forthy42/b16-small/alu.pdf

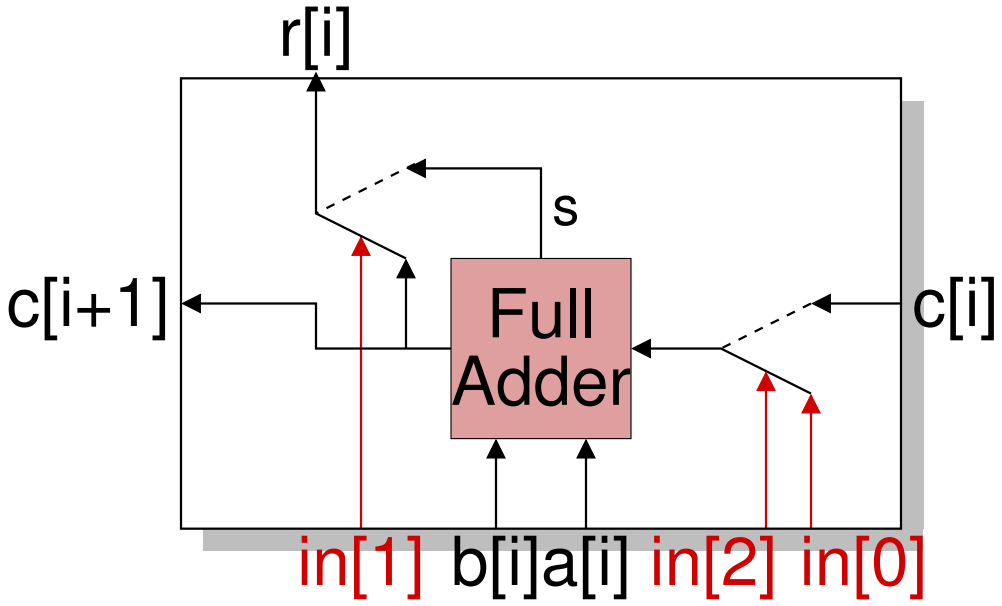
[picture p2: figure]
Adder; Full
