forthy42/b16-small/b16-small.pdf

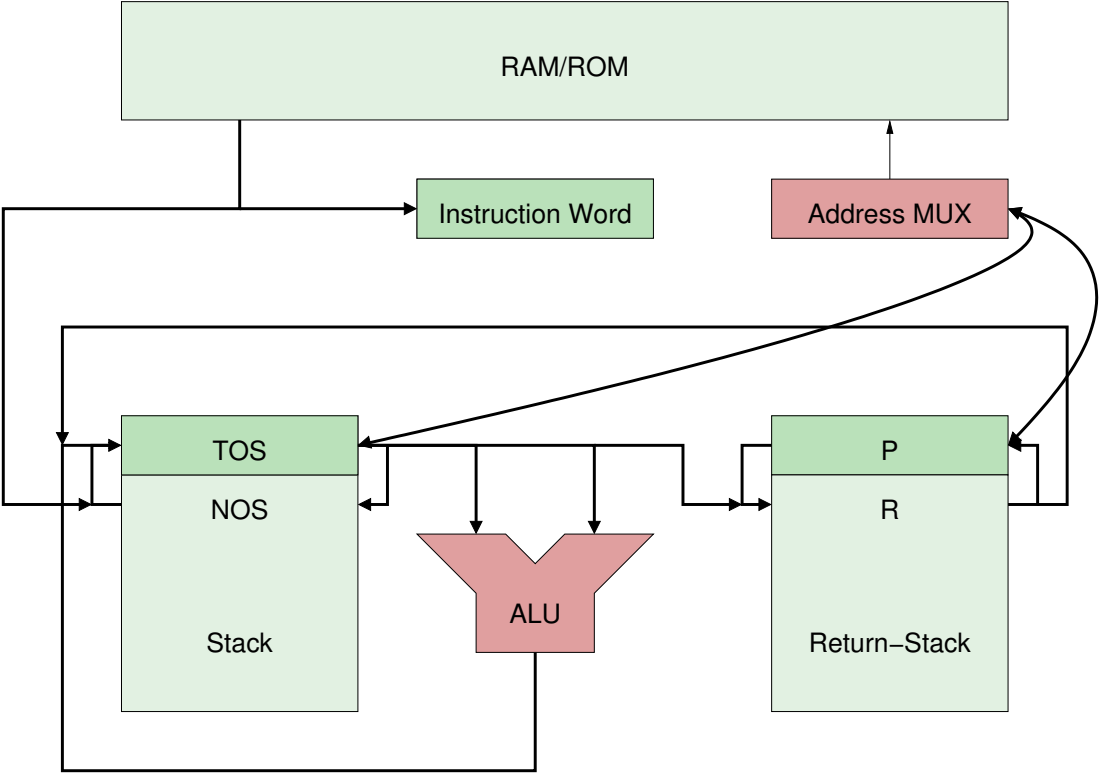
[picture p3: page 1]
ALU; Stack; Return−Stack; RAM/ROM; Instruction Word; Address MUX; NOS; TOS
