forthy42/b16-small/regmap.asm

\ b16 FPGA board regmap
$FE00 org
| TMR0H 0 ,
| TMR0L 0 ,
| TMR1H 0 ,
| TMR1L 0 ,
| TMR2H 0 ,
| TMR2L 0 ,
| TMR3H 0 ,
| TMR3L 0 ,
| THRES0H 0 ,
| THRES0L 0 ,
| THRES1H 0 ,
| THRES1L 0 ,
| THRES2H 0 ,
| THRES2L 0 ,
| THRES3H 0 ,
| THRES3L 0 ,
| CYCLE0H 0 ,
| CYCLE0L 0 ,
| CYCLE1H 0 ,
| CYCLE1L 0 ,
| CYCLE2H 0 ,
| CYCLE2L 0 ,
| CYCLE3H 0 ,
| CYCLE3L 0 ,
$FF00 org
| LED7 0 ,
$FF08 org
| IRQMASK 0 c,
| IRQACT 0 c,
$FF10 org
| TVAL0 0 ,
| TVAL1 0 ,
| TIMERVAL0 0 ,
| TIMERVAL1 0 ,
$FF20 org
| GPIO00 0 ,
| GPIO01 0 ,
| GPIO02 0 ,
$FF28 org
| GPIO00t 0 ,
| GPIO01t 0 ,
| GPIO02t 0 ,
$FF30 org
| GPIO10 0 ,
| GPIO11 0 ,
| GPIO12 0 ,
$FF38 org
| GPIO10t 0 ,
| GPIO11t 0 ,
| GPIO12t 0 ,
