forthy42/b16-small/(commit log)

2009-03-26 Added verilog source to avoid Make for building the source
    [b16.v]
2009-03-26 Added gforth to assembler script
2009-03-31 Added test for byte swapping
    [test.asm]
2009-04-05 Removed READY flag (doesn't work, use run flag instead!)
    [b16.v, b16top.v]
2009-04-10 Added uart
2009-04-10 Added reset value for tx
    [uart.v]
2009-04-11 Added debugger uart
2009-04-11 UART debugger seems to work
2009-04-11 status fixed, ramstyle for Cyclone
    [b16top.v]
2009-04-13 Small fixes to improve debugging
    [b16top.v]
2009-04-13 fixed ready switch
2009-04-28 Works now under Windows (current SVN bigForth required)
2009-05-22 Added wait/sleep for timer
2009-05-22 Made timer sleep work
2009-06-06 Changed glue
2009-08-24 Assembler works again with gforth
2011-01-27 Removed leda pragma
2011-03-19 Changed casez to case
2012-05-10 Changes to current bigForth Started triceps2 program
2012-05-17 Added final triangle calculation - only arccos() function missing
    [triceps2.asm]
2012-05-19 trig y direction is correct now
    [triceps2.asm]
2012-05-19 Calibrate offset of different towers
2012-05-20 Played first complete game - some minor coordinate problems left
    [triceps2.asm]
2012-05-23 Ergebnis Rework LinuxTag 1. Tag
    [triceps2.asm]
2013-04-17 Sourcecode for new board
2013-08-01 Calibrate motors
2019-12-29 Calibrate triceps 2D
